barryshaffer/roundDisp/3d models/sodastream-Hinge_Part_2x.stl

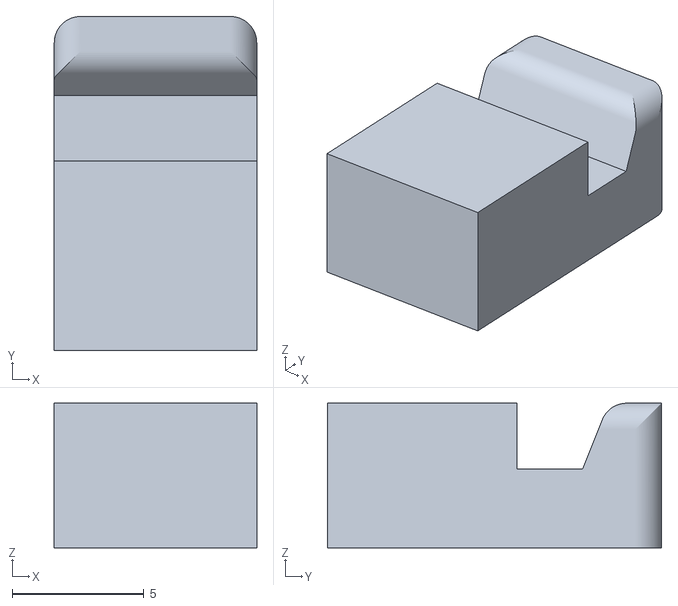
[picture p4: CAD file, 2026-10-12]
3d models/sodastream-Hinge_Part_2x.stl
7.70 x 12.7 x 5.50
