barryshaffer/roundDisp/3d models/sodastream-Cover.stl

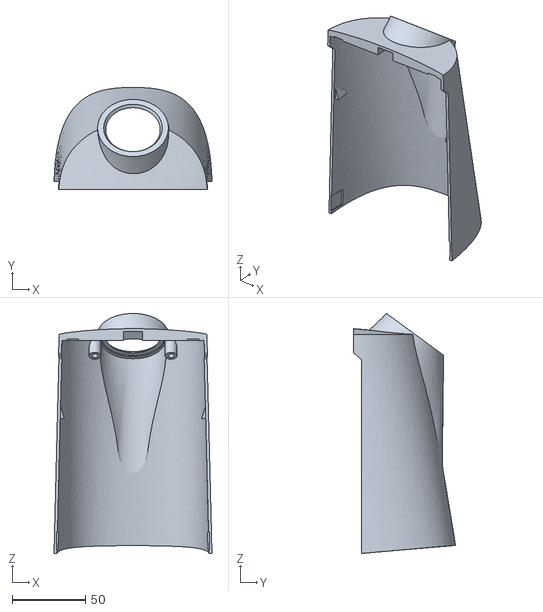
[picture p5: CAD file, 2026-10-12]
3d models/sodastream-Cover.stl
107.9 x 69.7 x 163.9
