barryshaffer/roundDisp/3d models/sodastream-Snap_RH.stl

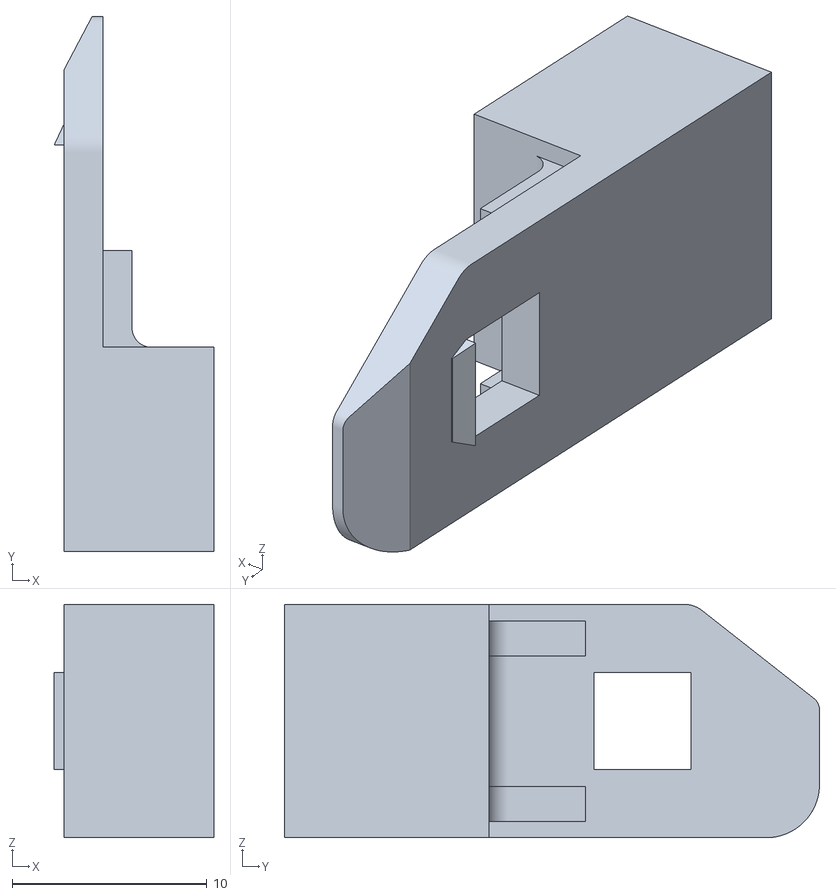
[picture p6: CAD file, 2026-10-12]
3d models/sodastream-Snap_RH.stl
8.20 x 27.5 x 12.0
