barryshaffer/roundDisp/3d models/sodastream-clamp.stl

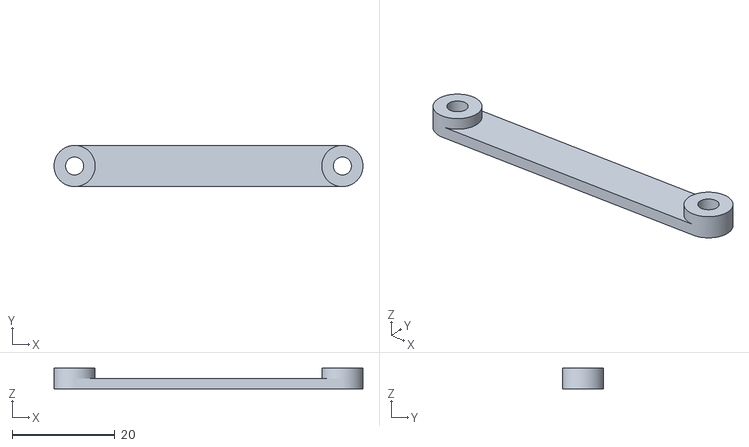
[picture p7: CAD file, 2026-10-12]
3d models/sodastream-clamp.stl
60.0 x 8.00 x 4.00
