barryshaffer/roundDisp/(list of files, cad)

Other CAD files:
3d models/sodastream-Snap_LH.stl
