barryshaffer/roundDisp/squareline/assets/test.png

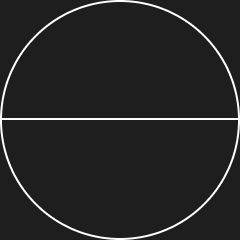
squareline/assets/test.png
