barryshaffer/roundDisp/(commit log)

2026-10-12 Added stl files
2026-10-12 Added assembly images and 3d print instructions
